7assanyahya/OrbDash/brand/png/orbdash-lockup-dark.png

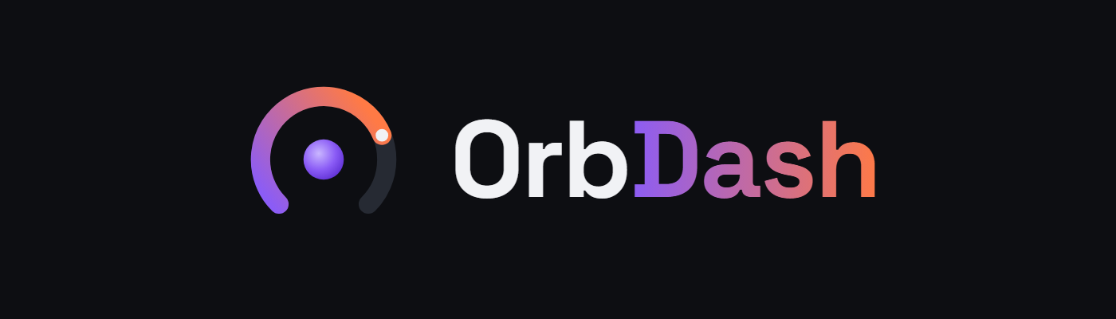
brand/png/orbdash-lockup-dark.png
