7assanyahya/OrbDash/brand/png/orbdash-lockup-light.png

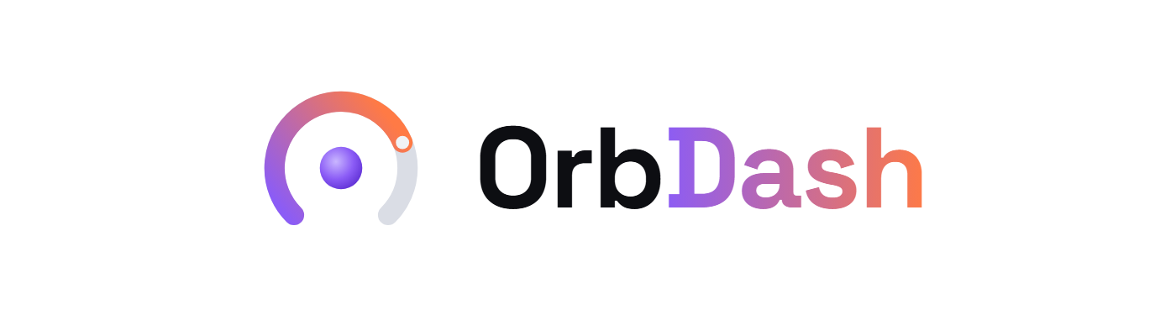
brand/png/orbdash-lockup-light.png
