7assanyahya/OrbDash/brand/png/orbdash-mark-512.png

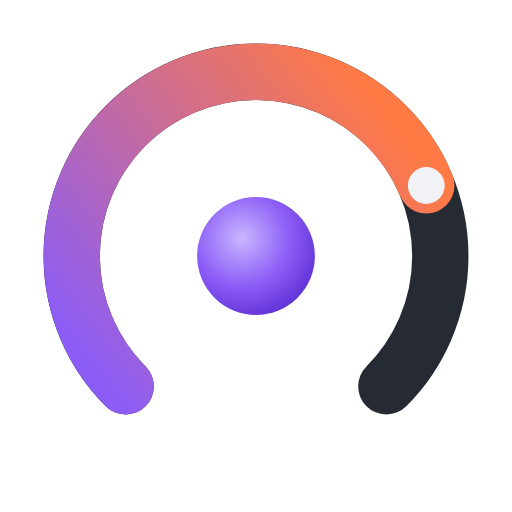
brand/png/orbdash-mark-512.png
