7assanyahya/OrbDash/case/mini/stl/orbdash_mini_retainer.stl

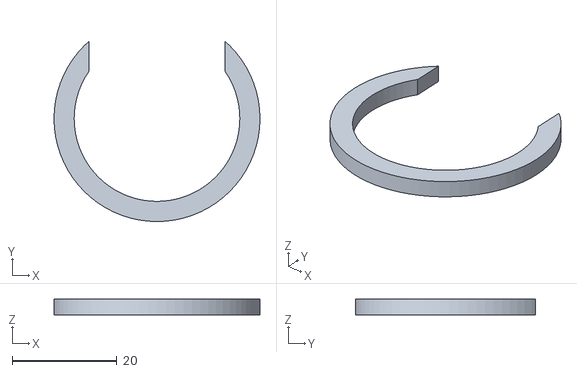
[picture p11: CAD file, 2026-11-02]
case/mini/stl/orbdash_mini_retainer.stl
39.3 x 34.4 x 3.00
