7assanyahya/OrbDash/case/pro/stl/orbdash_pro_shell.stl

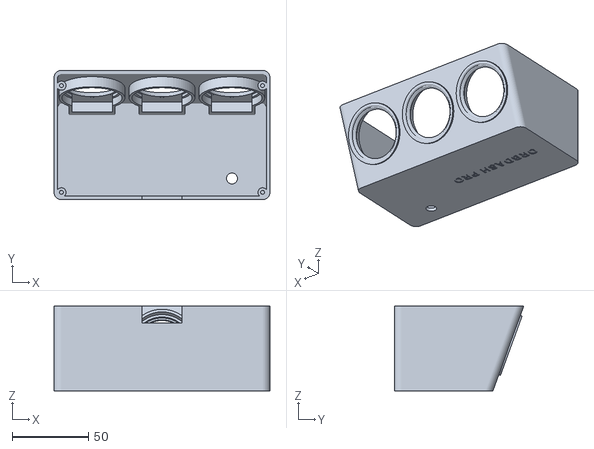
[picture p12: CAD file, 2026-11-02]
case/pro/stl/orbdash_pro_shell.stl
142.0 x 85.1 x 55.6
