7assanyahya/OrbDash/case/stl/orbdash_shell.stl

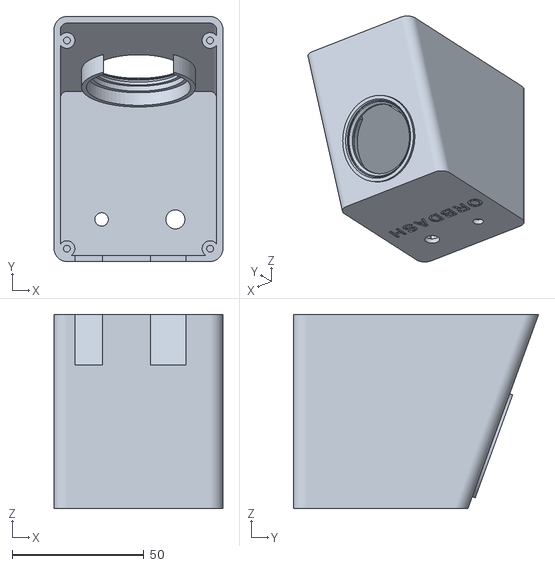
[picture p13: CAD file, 2026-11-01]
case/stl/orbdash_shell.stl
64.1 x 93.0 x 73.6
