7assanyahya/OrbDash/case/mini/stl/orbdash_mini_shell.stl

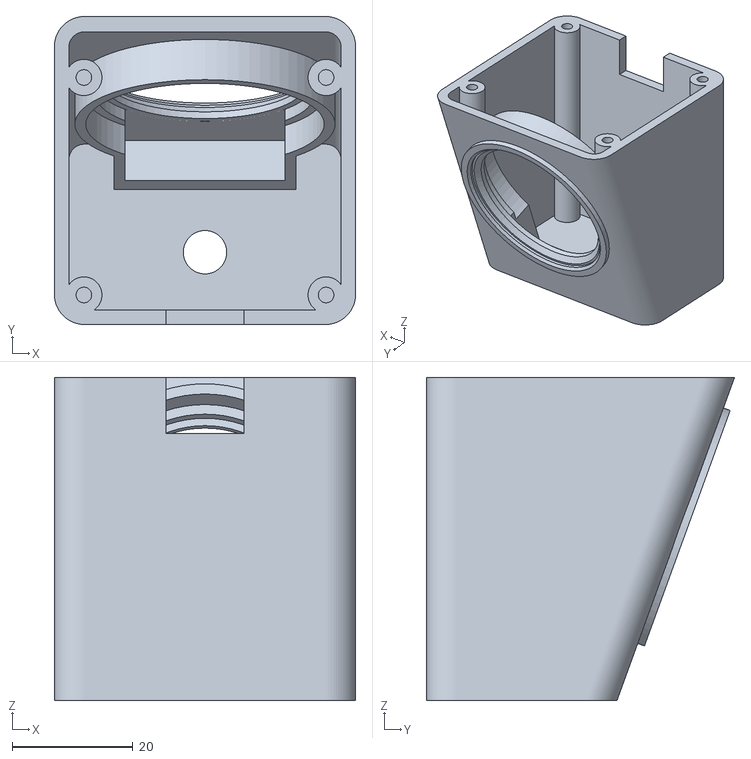
[picture p14: CAD file, 2026-11-02]
case/mini/stl/orbdash_mini_shell.stl
50.0 x 51.1 x 53.6
