7assanyahya/OrbDash/case/pro/stl/orbdash_pro_plate.stl

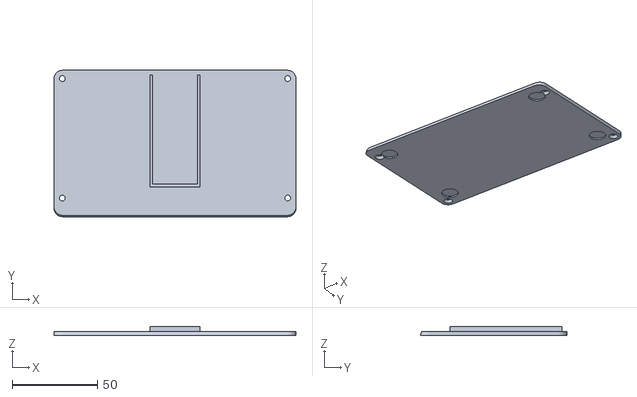
[picture p15: CAD file, 2026-11-02]
case/pro/stl/orbdash_pro_plate.stl
142.0 x 86.0 x 5.40
