7assanyahya/OrbDash/case/mini/stl/orbdash_mini_plate.stl

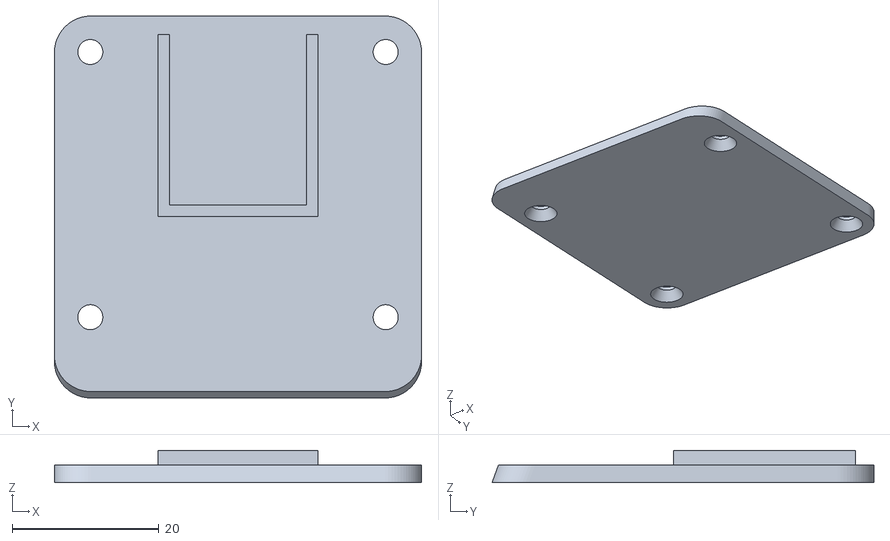
[picture p16: CAD file, 2026-11-02]
case/mini/stl/orbdash_mini_plate.stl
50.0 x 52.0 x 4.40
