7assanyahya/OrbDash/case/stl/orbdash_plate.stl

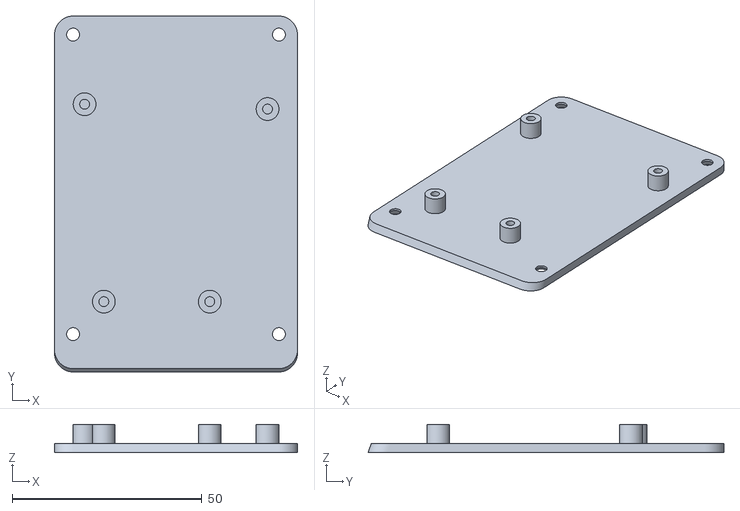
[picture p17: CAD file, 2026-11-01]
case/stl/orbdash_plate.stl
64.1 x 93.9 x 7.40
