7assanyahya/OrbDash/(list of files, cad)

Other CAD files:
case/stl/orbdash_retainer.stl
case/pro/stl/orbdash_pro_retainer.stl
