7assanyahya/OrbDash/docs/wiring.png

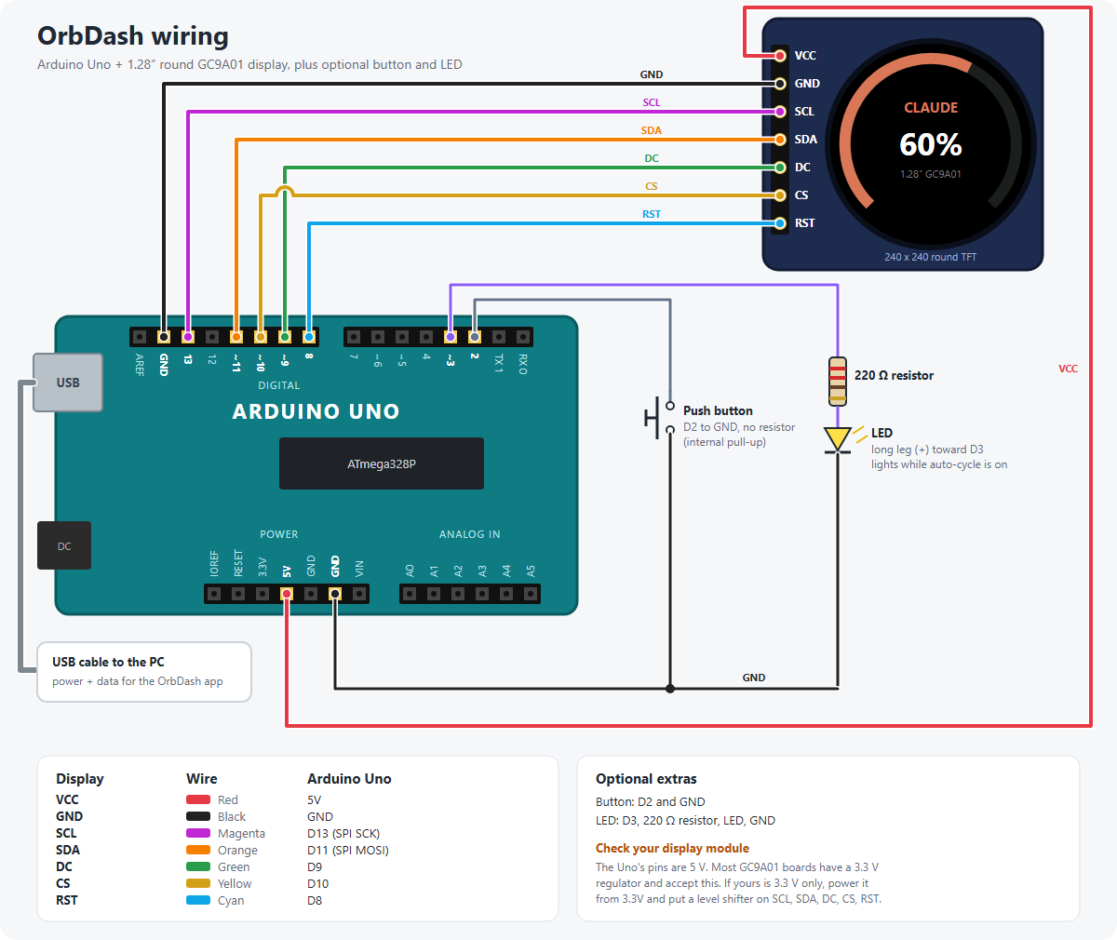
docs/wiring.png
