7assanyahya/OrbDash/docs/wiring_mini.png

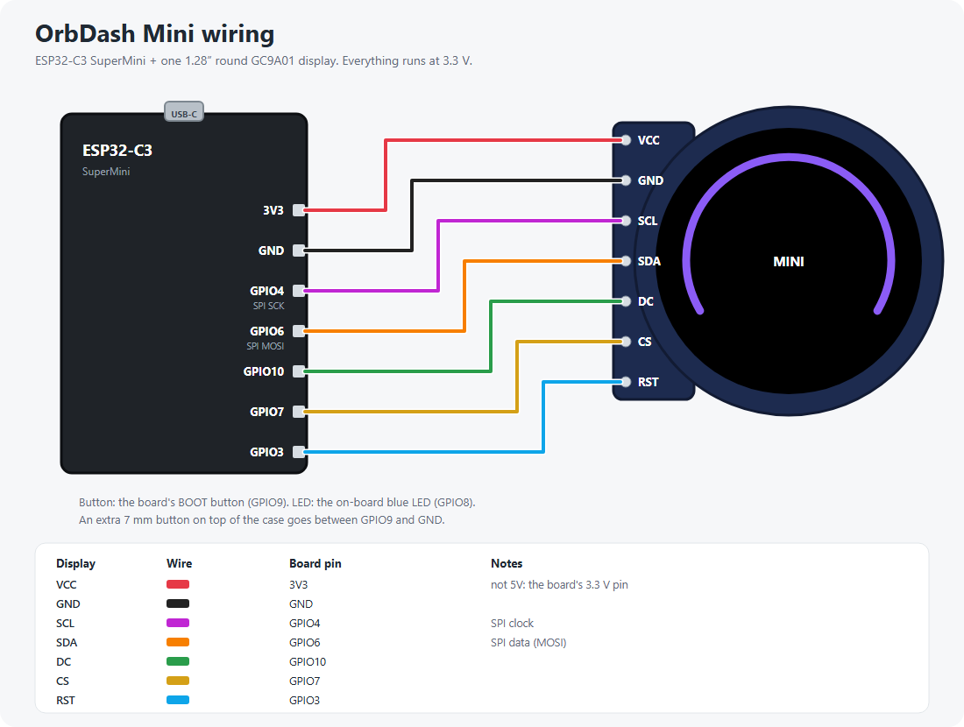
docs/wiring_mini.png
