7assanyahya/OrbDash/docs/wiring_pro.png

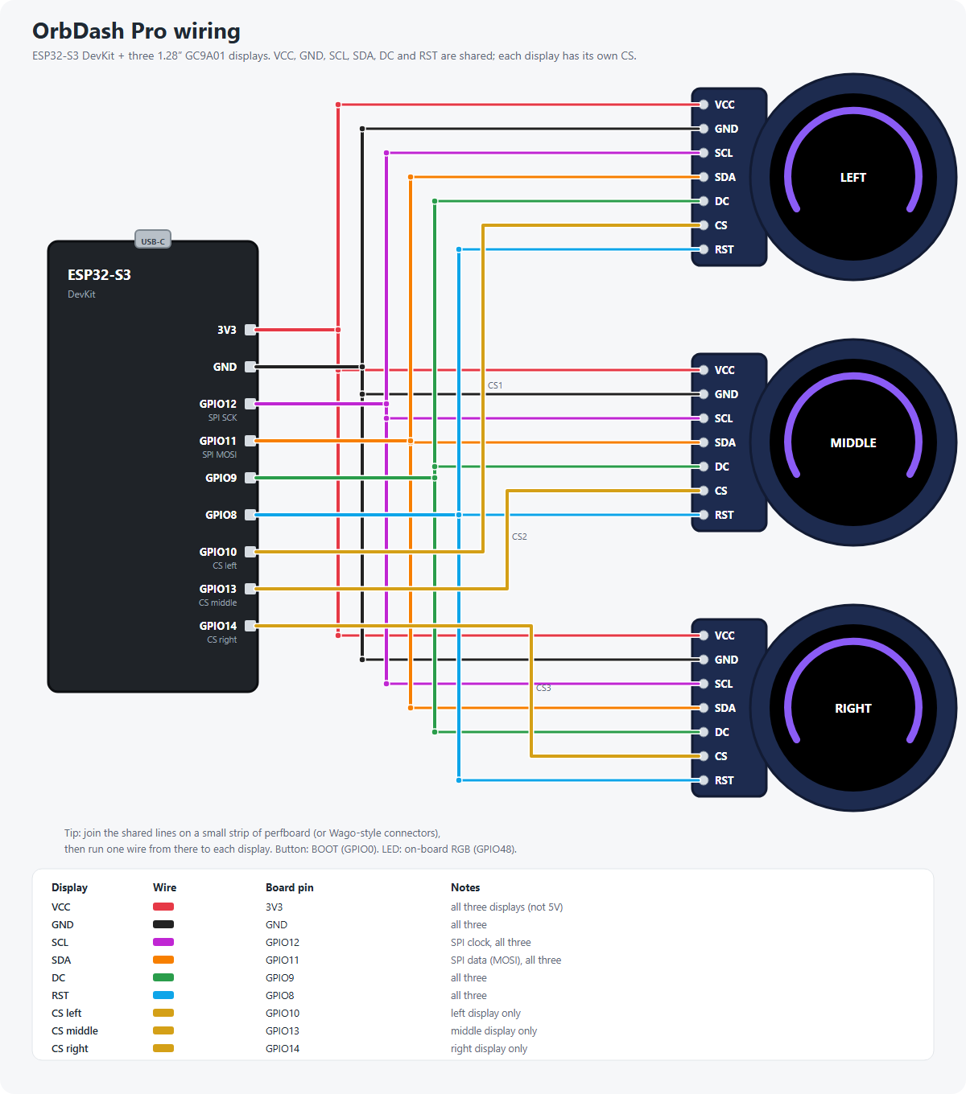
docs/wiring_pro.png
