7assanyahya/OrbDash/(commit log)

2026-11-01 Add OrbDash firmware for 1.28" GC9A01 TFT display with multi-mode dashboard functionality
    - Implemented display modes for usage tracking, clock, system stats, and custom widgets.
    - Added button controls for mode cycling, screen rotation, and auto-cycle toggle.
    - Integrated serial communication protocol for data exchange with the OrbDash app.
    - Developed boot animation and dynamic UI updates based on received data.
    - Included gauge animations and orbiting comet effects for visual feedback.
    - Defined color schemes and layout for various display modes.
2026-11-01 Refactor code structure for improved readability and maintainability
    [orbdash_case.scad, orbdash_plate.stl, orbdash_retainer.stl, orbdash_shell.stl]
2026-11-01 feat: release version 1.1.0 with new GT Gauge widget and app redesign
    - Added GT Gauge widget for CPU load visualization
    - Introduced GPU load monitoring from NVIDIA and Windows sources
    - Implemented waiting animation for data connection
    - Created 3D printer templates for OctoPrint and Klipper
    - Revamped app design with dark theme and sidebar navigation
    - Established brand identity with new logo and colors
    - Added demo mode for showcasing app functionality
    - Updated firmware to report version at startup
    fix: improved case design for better display fit and accessibility
    - Adjusted display pocket for board header tab and solder joints
    - Optimized firmware to reduce RAM usage for screen labels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
    [orbdash_case.scad, orbdash_retainer.stl, orbdash_shell.stl]
2026-11-02 Add OrbDash firmware for ESP32 with support for Mini and Pro devices
    - Implemented display handling for ESP32-C3 (Mini) and ESP32-S3 (Pro) with respective configurations.
    - Created a 240x240 pixel buffer for smooth rendering to the GC9A01 displays.
    - Added support for multiple screen modes including gauges, clocks, and system metrics.
    - Integrated button controls for navigating between widgets and auto-cycling through modes.
    - Established a serial communication protocol for data exchange with a PC application.
    - Included boot animation and waiting screen when not linked to a PC.
    - Defined color constants and drawing functions for UI elements.
    [orbdash_mini.scad, orbdash_mini_plate.stl, orbdash_mini_retainer.stl, orbdash_mini_shell.stl, orbdash_pro.scad, orbdash_pro_plate.stl, orbdash_pro_retainer.stl, orbdash_pro_shell.stl]
2026-11-02 feat: add support for multiple OrbDash devices with dynamic layout and screen management
